matimucha/open_lab/auto_switch_off.asc

C1: cap; 220n
C2: cap; 220n
C3: cap; 220n
C4: cap; 100n
D1: diode
D2: LED
D3: LED
PR1_1: res; R = (time*1e6)+1
PR1_2: res; R = 1e6 - (time*1e6) +1
Q1: pnp; PH_BC327-40
R1: res; 100k
R2: res; 1000k
R3: res; 1000k
R4: res; 100k
R5: res; 1.5k
R6: res; 100k
R7: res; 1000k
R8: res; 100k
R9: res; 1.5k
R10: res; 250
U1: UniversalOpamp2
U2: CD4013B
U3: CD4013B
V1: voltage; 5
V2: voltage; PULSE(0 3.5 100m 1u 1u 100m 200m 2)
Named nets: 0
.tran 1
.inc CD4000.lib
